scottjgibson/bobc_hardware/RosettaBone_Redux/RBR.Kit-Checklist.odt

100n

10u

100u

220R

330R

2K0

2K7

4k7

10k

100k

Shunt

SW_PUSH

Fuses

Terminal Blocks

Pololu Sockets

Dual row headers

Single row headers

KK Connectors

4-40 hardware

SS14

Yellow LED

Green LED

Red LED

2N7002K

DNM2075U

IRLB8743PBF

74CBTD3861

74ACT244

24C256

100n

10u

100u

220R

330R

2K0

2K7

4k7

10k

100k

Shunt

SW_PUSH

Fuses

Terminal Blocks

Pololu Sockets

Dual row headers

Single row headers

KK Connectors

4-40 hardware

SS14

Yellow LED

Green LED

Red LED

2N7002K

DNM2075U

IRLB8743PBF

74CBTD3861

74ACT244

24C256

100n

10u

100u

220R

330R

2K0

2K7

4k7

10k

100k

Shunt

SW_PUSH

Fuses

Terminal Blocks

Pololu Sockets

Dual row headers

Single row headers

KK Connectors

4-40 hardware

SS14

Yellow LED

Green LED

Red LED

2N7002K

DNM2075U

IRLB8743PBF

74CBTD3861

74ACT244

24C256

100n

10u

100u

220R

330R

2K0

2K7

4k7

10k

100k

Shunt

SW_PUSH

Fuses

Terminal Blocks

Pololu Sockets

Dual row headers

Single row headers

KK Connectors

4-40 hardware

SS14

Yellow LED

Green LED

Red LED

2N7002K

DNM2075U

IRLB8743PBF

74CBTD3861

74ACT244

24C256

100n

10u

100u

220R

330R

2K0

2K7

4k7

10k

100k

Shunt

SW_PUSH

Fuses

Terminal Blocks

Pololu Sockets

Dual row headers

Single row headers

KK Connectors

4-40 hardware

SS14

Yellow LED

Green LED

Red LED

2N7002K

DNM2075U

IRLB8743PBF

74CBTD3861

74ACT244

24C256

100n

10u

100u

220R

330R

2K0

2K7

4k7

10k

100k

Shunt

SW_PUSH

Fuses

Terminal Blocks

Pololu Sockets

Dual row headers

Single row headers

KK Connectors

4-40 hardware

SS14

Yellow LED

Green LED

Red LED

2N7002K

DNM2075U

IRLB8743PBF

74CBTD3861

74ACT244

24C256

100n

10u

100u

220R

330R

2K0

2K7

4k7

10k

100k

Shunt

SW_PUSH

Fuses

Terminal Blocks

Pololu Sockets

Dual row headers

Single row headers

KK Connectors

4-40 hardware

SS14

Yellow LED

Green LED

Red LED

2N7002K

DNM2075U

IRLB8743PBF

74CBTD3861

74ACT244

24C256

100n

10u

100u

220R

330R

2K0

2K7

4k7

10k

100k

Shunt

SW_PUSH

Fuses

Terminal Blocks

Pololu Sockets

Dual row headers

Single row headers

KK Connectors

4-40 hardware

SS14

Yellow LED

Green LED

Red LED

2N7002K

DNM2075U

IRLB8743PBF

74CBTD3861

74ACT244

24C256
