scottjgibson/bobc_hardware/RosettaBone_Redux/RBR-BOM-v1.1.xlsx

Sheet: CRAMPS-BOM
Item | Component | Notes | Quantity | Reference | Manufacturer | Part No. | Digikey Description | Digikey Part No | 1 | 10 | 25 | 50 | 100 | Cost
1 | 100u 35V |  | 7 | C201 C202 C203 C204 C205 C206 C402 | Nichicon | UCD1V101MCL6GS | CAP ALUM 100UF 35V 20% SMD | 493-6420-1-ND | 0.78000 | 0.65700 | 0.65700 | 0.65700 | 0.41170 | $5.46
2 | 10u 10V |  | 4 | C506 C507 C508 C509 | Taiyo Yuden | LMK212F106ZG-T | CAP CER 10UF 10V Y5V 0805 | 587-1312-1-ND | 0.20000 | 0.13800 | 0.13800 | 0.07940 | 0.65400 | $0.80
3 | 100n |  | 9 | C301 C302 C303 C401 C501 C502 C503 C504 C505 | Taiyo Yuden | GMK212BJ104KGHT | CAP CER 0.1UF 35V 10% X5R 0805 | 587-3364-1-ND | 0.30000 | 0.20100 | 0.20100 | 0.10440 | 0.08050 | $2.70
4 | ES1F |  | 6 | D401 D402 D403 D404 D405 D406 | Fairchild | ES1F | DIODE FAST REC 300V 1A SMA | ES1FCT-ND | 0.59000 | 0.42500 | 0.42500 | 0.33080 | 0.25060 | $3.54
5 | LED GRN |  | 3 | LD101 LD102 LD301 | Osram | LG R971-KN-1 | LED CHIPLED 570NM GREEN 0805 SMD | 475-1410-1-ND | 0.10000 | 0.08100 | 0.08100 | 0.08100 | 0.06540 | $0.30
6 | LED RED |  | 7 | LD302 LD401 LD402 LD403 LD404 LD405 LD406 | Osram | LH R974-LP-1 | LED CHIPLED 645NM RED DIFF 0805 | 475-1415-1-ND | 0.10000 | 0.08400 | 0.08400 | 0.08400 | 0.06600 | $0.70
7 | FUSE HOLDER |  | 3 | F201 F401 F402 | Keystone | 3588TR | FUSE HOLDER BLADE 500V 20A PCB | 3588KCT-ND | 1.62000 | 1.42500 | 1.42500 | 1.28560 | 1.22960 | $4.86
8 | FUSE 10A |  | 2 | F201 F401 | Littelfuse | 0297010.L | FUSE BLADE 10A 32V MINI FAST-AC | F4264-ND | 0.48000 | 0.45300 | 0.41720 | 0.38100 | 0.31640 | $0.96
9 | FUSE 15A |  | 1 | F402 | Littelfuse | 0297015.L | FUSE BLADE 15A 32V MINI FAST-AC | F4265-ND | 0.48000 | 0.45300 | 0.41720 | 0.38100 | 0.31640 | $0.48
10 | Power 3.5mm |  | 4 | P101 P406 P408 P411 | Phoenix | 1984617 | CONN TERM BLOCK T/H 2POS 3.5MM | 277-1721-ND | 0.48000 | 0.45500 | 0.45500 | 0.43500 | 0.42310 | $1.92
11 | Power 5.08mm |  | 4 | P204 P401 P402 P404 | Phoenix | 1715721 | CONN TERM BLOCK 2POS 5.08MM PCB | 277-1263-ND | 1.38000 | 1.32300 | 1.32300 | 1.26540 | 1.23090 | $5.52
12 | BB_EXP_CONN | 1 | 2 | P103 P104 | Major League | SSHQ-123-D-08-GT-LF | CONN RCPT .100" 46POS DUAL TIN |  | 2.50000 |  |  |  |  | $5.00
13 | Serial0 |  | 1 | P102 | Arduino |  | 6 pin stacking header |  | 0.25000 |  |  |  |  | $0.25
14 | Molex 2 pin |  | 3 | P302 P409 P410 | Molex | 22-23-2021 | CONN HEADER 2POS .100 VERT TIN | WM4200-ND | 0.24000 | 0.22200 | 0.18920 | 0.16580 | 0.15390 | $0.72
16 | Molex 4 pin |  | 7 | P205 P206 P207 P211 P212 P213 P407 | Molex | 22-23-2041 | CONN HEADER 4POS .100 VERT TIN | WM4202-ND | 0.44000 | 0.42400 | 0.36400 | 0.30920 | 0.29710 | $3.08
17 | Header 2 | 2 | 4 | P103 P104 P307 JP501 | Harwin | M20-9990245 | SIL VERTICAL PC TAIL PIN HEADER | 952-2261-ND | 0.17000 | 0.15200 | 0.11320 | 0.09700 | 0.09380 | $0.68
18 | Header 4 | 2 | 2 | P303 P304 | Harwin | M20-9990445 | DIL VERTICAL PC TAIL PIN HEADER | 952-2265-ND | 0.19000 | 0.18000 | 0.15320 | 0.13420 | 0.12460 | $0.38
19 | Header 6 | 2 | 2 | P305 P502 | Harwin | M20-9990645 | SIL VERTICAL PC TAIL PIN HEADER | 952-2269-ND | 0.29000 | 0.27000 | 0.23000 | 0.20140 | 0.18690 | $0.58
20 | Shunt | 4 | 3 | P301 JP501 | TE | 382811-8 | SHUNT, ECON, PHBR 5AU, BLACK | A26228-ND | 0.18700 | 0.18700 | 0.18700 | 0.11960 | 0.11550 | $0.56
21 | Header 2x2 | 2,3 | 0 | P301 | Harwin | M20-9980245 | DIL VERTICAL PC TAIL PIN HEADER | 952-2119-ND | 0.26000 | 0.24700 | 0.21080 | 0.18460 | 0.17140 | $0.00
22 | Header 3X2 | 2,3 | 0 | P201 P202 P203 P208 P209 P210 | Harwin | M20-9980345 | DIL VERTICAL PC TAIL PIN HEADER | 952-2120-ND | 0.29000 | 0.27000 | 0.23000 | 0.20140 | 0.18690 | $0.00
23 | Header 6X2 | 2 | 1 | P501 | Harwin | M20-9980645 | DIL VERTICAL PC TAIL PIN HEADER | 952-2125-ND | 0.53000 | 0.50300 | 0.43120 | 0.36660 | 0.35230 | $0.53
24 | Header 4X2 | 2 | 1 | P503 | Harwin | M20-9980445 | DIL VERTICAL PC TAIL PIN HEADER | 952-2122-ND | 0.36000 | 0.33600 | 0.28760 | 0.24440 | 0.23490 | $0.36
25 | 220R |  | 6 | R401 R403 R405 R408 R410 R411 | Stackpole | RMCF0805FT220R | RES 220 OHM 1/8W 1% 0805 | RMCF0805FT220RCT-ND | 0.05000 | 0.03700 | 0.03700 | 0.02060 | 0.01560 | $0.30
26 | 330R |  | 4 | R101 R102 R302 R305 | Stackpole | RMCF0805FT330R | RES 330 OHM 1/8W 1% 0805 | RMCF0805FT330RCT-ND | 0.05000 | 0.03700 | 0.03700 | 0.02060 | 0.01560 | $0.20
27 | 2K0 1% |  | 4 | R501 R502 R503 R504 | Stackpole | RMCF0805FT2K00 | RES 2K OHM 1/8W 1% 0805 | RMCF0805FT2K00CT-ND | 0.05000 | 0.03700 | 0.03700 | 0.02060 | 0.01560 | $0.20
28 | 2K7 |  | 6 | R402 R404 R406 R407 R409 R412 | Stackpole | RMCF0805FT2K70 | RES 2.7K OHM 1/8W 1% 0805 | RMCF0805FT2K70CT-ND | 0.05000 | 0.03700 | 0.03700 | 0.02060 | 0.01560 | $0.30
29 | 4k7 |  | 5 | R303 R505 R506 R507 R508 | Stackpole | RMCF0805FT4K70 | RES 4.7K OHM 1/8W 1% 0805 | RMCF0805FT4K70CT-ND | 0.05000 | 0.03700 | 0.03700 | 0.02060 | 0.01560 | $0.25
30 | 10k |  | 2 | R301 R304 | Stackpole | RMCF0805FT10K0 | RES 10K OHM 1/8W 1% 0805 | RMCF0805FT10K0CT-ND | 0.05000 | 0.03700 | 0.03700 | 0.02060 | 0.01560 | $0.10
31 | 100k |  | 6 | R201 R202 R203 R204 R205 R206 | Stackpole | RMCF0805FT100K | RES 100K OHM 1/8W 1% 0805 | RMCF0805FT100KCT-ND | 0.05000 | 0.03700 | 0.03700 | 0.02060 | 0.01560 | $0.30
32 | 10k Resitor Pack |  | 7 | RP301 RP302 RP303 RP304 RP305 RP501 RP502 | Bourns | CAT16-103J4LF | RES ARRAY 10K OHM 4 RES 1206 | CAT16-103J4LFCT-ND | 0.13000 | 0.08700 | 0.08280 | 0.07840 | 0.06800 | $0.91
33 | Switch |  | 2 | SW101 SW102 | TE | FSM2JH | SWITCH TACTILE SPST-NO 0.05A 12V | 450-1649-ND | 0.15000 | 0.14500 | 0.14080 | 0.13580 | 0.12820 | $0.30
34 | SM_DRIVER Socket |  | 4 | U201 U202 U203 U204 U205 U206 | Sullins | PPTC241LFBN-RC | CONN HEADER FEMALE 24POS.1" TIN | S7022-ND | 1.96000 | 1.61500 | 1.51400 | 1.34560 | 1.21110 | $7.84
35 | SM_DRIVER |  | 0 | U201 U202 U203 U204 U205 U206 | Pololu | 2133 | DRV8825 Stepper Motor Carrier, High Current |  | 13.95000 | 11.95000 | 10.25000 | 10.25000 | 8.75000 | $0.00
36 | 24C512 |  | 1 | U301 | On Semiconductor | CAT24C512WI-GT3 | IC EEPROM 512KBIT 1MHZ 8SOIC | CAT24C512WI-GT3OSCT-ND | 1.29000 | 1.14300 | 1.03200 | 1.03200 | 0.90290 | $1.29
37 | 74ACT244 |  | 1 | U302 | Fairchild | 74ACT244SCX | IC BUFF/DVR TRI-ST DUAL 20SOIC | 74ACT244SCXCT-ND | 0.78000 | 0.68200 | 0.60200 | 0.60200 | 0.52470 | $0.78
38 | 74CBTLV3861 |  | 1 | U501 | TI | SN74CBTD3861DW | IC 10-BIT FET BUS SW 24-SOIC | 296-6486-5-ND | 0.92000 | 0.92000 | 0.71320 | 0.71320 | 0.62120 | $0.92
39 | 2N7002 |  | 7 | Q101 Q301 Q302 Q303 Q304 Q305 Q306 | NXP | 2N7002P,215 | MOSFET N-CH SGL 60V SOT-23 | 568-5818-1-ND | 0.17000 | 0.15200 | 0.13920 | 0.13920 | 0.09990 | $1.19
40 | DMN2075U |  | 2 | Q403 Q405 | Diodes Inc | DMN2075U-7 | MOSFET N-CH 20V 4.2A SOT23 | DMN2075U-7DICT-ND | 0.54000 | 0.38800 | 0.30240 | 0.30240 | 0.22900 | $1.08
41 | IRLB8743PBF |  | 4 | Q401 Q402 Q404 Q406 | International Rectifier | IRLB8743PBF | MOSFET N-CH 30V 78A TO220AB | IRLB8743PBF-ND | 1.69000 | 1.04100 | 0.93120 | 0.84620 | 0.76140 | $6.76
 |  |  |  |  |  |  |  |  |  |  |  |  |  | $62.10
Notes
1 | Alternate stacking BeagleBone Headers:
 | MajorLeague SSHQ-123-D-08-GT-LF
 | Samtec SSQ-123-03-T-D (Tin)
 | Samtec SSQ-123-03-G-D (Gold)
 | Or use plain pin headers if you do not require additional expansion capes
2 | To save money on all the pin headers when buying parts for a few boards, you can get large breakaway headers
 | instead of the individual parts. You will need a total of:
 | 57 pins of single-row header
 | 74 pins of dual-row header
 | Which you can get using
 | (2) Harwin M20-9993645 36-pin single-row header
 | (2) Harwin M20-9983645 72-pin dual-row header
3 | These jumpers are optional. To use the on board shorts must be removed.
4 | Quantity required will vary. See note 3.

Sheet: Sheet1
4 | ES1F | 6 | D401 D402 D403 D404 D405 D406 | Fairchild | ES1F | DIODE FAST REC 300V 1A SMA | ES1FCT-ND | 0.59000 | 0.42500 | 0.42500 | 0.33080 | 0.25060 | $3.54
4 | SK310A-TP | 6 | D401 D402 D403 D404 D405 D406 | Micro Commercial | SK310A-TP | DIODE SCHOTTKY 100V 3A SMA | SK310A-TPCT-ND | 0.68000 | 0.47900 | 0.39400 | 0.31480 | 0.31480 | $4.08
4 | SK310A-TP | 6 | D401 D402 D403 D404 D405 D406 | Micro Commercial | SK4200L-TP | DIODE SCHOTTKY 200V 4A DO214AB | SK4200L-TPMSCT-ND | 0.59000 | 0.49400 | 0.43280 | 0.43280 | 0.37030 | $3.54
7 | FUSE HOLDER | 3 | F201 F401 F402 | Keystone | 3588TR | FUSE HOLDER BLADE 500V 20A PCB | 3588KCT-ND | 1.62000 | 1.42500 | 1.42500 | 1.28560 | 1.22960 | $4.86
7 | FUSE HOLDER | 6 | F201 F401 F402 | Keystone | 3557 | FUSE CLIP BLADE 500V 20A PCB | 3557K-ND | 0.26000 | 0.24000 | 0.24000 | 0.18760 | 0.16600 | $1.56
36 | 74ACT244 | 1 | U302 | Fairchild | 74ACT244SCX | IC BUFF/DVR TRI-ST DUAL 20SOIC | 74ACT244SCXCT-ND | 0.78000 | 0.68200 | 0.60200 | 0.60200 | 0.52470 | $0.78
36 | 74ACT244 | 1 | U302 | Fairchild | 74ACT244MTCX | IC BUFF/DVR TRI-ST DUAL 20TSSOP | 74ACT244MTCXCT-ND | 0.64000 | 0.53700 | 0.47040 | 0.47040 | 0.40250 | $0.64
37 | 74CBTLV3861 | 1 | U501 | TI | SN74CBTD3861DBQR | IC 10-BIT FET BUS SW 24QSOP | 296-6483-1-ND | 0.87000 | 0.76100 | 0.67280 | 0.67280 | 0.58630 | $0.87
37 | 74CBTLV3861 | 1 | U501 | TI | SN74CBTD3861DW | IC 10-BIT FET BUS SW 24-SOIC | 296-6486-5-ND | 0.92000 | 0.92000 | 0.71320 | 0.71320 | 0.62120 | $0.92
12 | BB_EXP_CONN | 2 | P103 P104 | SamTec | SSQ-123-03-T-D | CONN RCPT .100" 46POS DUAL TIN | SAM1204-23-ND | 5.93000 | 5.30600 | 5.30600 | 5.30600 | 4.37010 | $11.86
12 | BB_EXP_CONN | 2 | P103 P104 | Major League | SSHQ-123-D-08-GT-LF | CONN RCPT .100" 46POS DUAL TIN |  | 2.50000 |  |  |  |  | $5.00
14 | Molex 2 pin | 3 | P302 P409 P410 | Molex | 22-23-2021 | CONN HEADER 2POS .100 VERT TIN | WM4200-ND | 0.24000 | 0.22200 | 0.18920 | 0.16580 | 0.15390 | $0.72
14 | Molex 2 pin | 3 | P302 P409 P410 | Molex | 20-60-4020 | CONN HEADER 2POS .156 VERT TIN | WM4620-ND | 0.31000 | 0.29300 | 0.25160 | 0.21380 | 0.20540 | $0.93
10 | Power 3.5mm | 4 | P101 P406 P408 P411 | Phoenix | 1984617 | CONN TERM BLOCK T/H 2POS 3.5MM | 277-1721-ND | 0.48000 | 0.45500 | 0.45500 | 0.43500 | 0.42310 | $1.92
10 | Molex 2 pin | 4 | P302 P409 P410 | Molex | 20-60-4020 | CONN HEADER 2POS .156 VERT TIN | WM4620-ND | 0.31000 | 0.29300 | 0.25160 | 0.21380 | 0.20540 | $1.24
