scottjgibson/bobc_hardware/RosettaBone_Redux/RBR.BOM.DK.V1.0.xls

Digi-Key Part Number | Manufacturer | Manufacturer Part Number | Customer Reference | Quantity 1 | Quantity 2 | Quantity 3 | Mfg Std Lead Time | Description | Comments | RoHS Status | Lead Free Status | REACH Status
CAT16-103J4LFCT-ND | BOURNS INC (VA) | CAT16-103J4LF | RP1..RP802 | 5 | 0 | 0 | 12 Weeks | RES ARRAY 10K OHM 4 RES 1206 | Alternate Packaging Exists | RoHS Compliant | Lead free | Not Available
2N7002K-7DICT-ND | DIODES INCORPORATED (VA) | 2N7002K-7 | Q1..Q101,Q401,Q402 | 5 | 0 | 0 | 7 Weeks | MOSFET N-CH 60V 300MA SOT23-3 | Alternate Packaging Exists | RoHS Compliant | Lead free | Unaffected Jun-2012
DMN2075U-7DICT-ND | DIODES INCORPORATED (VA) | DMN2075U-7 | Q901,Q902 | 2 | 0 | 0 | 8 Weeks | MOSFET N-CH 20V 4.2A SOT23 | Alternate Packaging Exists | RoHS Compliant | Lead free | Unaffected Jun-2012
74ACT244SC-ND | FAIRCHILD SEMICONDUCTOR | 74ACT244SC | U2 | 1 | 0 | 0 | 7 Weeks | IC BUFF/DVR TRI-ST DUAL 20SOIC |  | RoHS Compliant | Lead free | Unaffected Jun-2011
LM7812ACT-ND | FAIRCHILD SEMICONDUCTOR | LM7812ACT | U3 | 1 | 0 | 0 | 7 Weeks | IC REG LDO 12V 1A TO220-3 |  | RoHS Compliant | Lead free | Unaffected Jun-2011
ES1FCT-ND | FAIRCHILD SEMICONDUCTOR (VA) | ES1F | D401..D404,D903,D904 | 6 | 0 | 0 | 7 Weeks | DIODE FAST REC 300V 1A SMA | Alternate Packaging Exists | RoHS Compliant | Lead free | Unaffected Jun-2011
952-1809-ND | HARWIN INC | M20-7820646 | P103 | 1 | 0 | 0 | 8 Weeks | 06-WAY SIL VERT SOCKET L/FREE |  | RoHS Compliant | Lead free | Not Available
952-2131-ND | HARWIN INC | M20-9983645 | DUAL ROW | 2 | 0 | 0 | 8 Weeks | DIL VERTICAL PC TAIL PIN HEADER |  | RoHS Compliant | Lead free | Not Available
952-2272-ND | HARWIN INC | M20-9993645 | SINGLE ROW | 2 | 0 | 0 | 8 Weeks | SIL VERTICAL PC TAIL PIN HEADER |  | RoHS Compliant | Lead free | Not Available
IRLB8743PBF-ND | INTERNATIONAL RECTIFIER | IRLB8743PBF | Q201..Q206 | 4 | 0 | 0 | 11 Weeks | MOSFET N-CH 30V 78A TO220AB |  | RoHS Compliant | Lead free | Unaffected Jun-2012
F065-ND | LITTELFUSE INC | 01530008Z | F101,F102,F103 | 3 | 0 | 0 | 9-11 Weeks | FUSE HOLDER BLADE 32V 15A PCB |  | RoHS Compliant | Lead free | Not Available
1N4148WXTPMSCT-ND | MICRO COMMERCIAL CO (VA) | 1N4148WX-TP | D1001..D1008 | 8 | 0 | 0 | 8 Weeks | DIODE SWITCHING 75V 0.15A SOD323 | Alternate Packaging Exists | RoHS Compliant | Lead free | Unaffected Jun-2012
WM4200-ND | MOLEX INC | 0022232021 | P105,P302,P901,P902 | 4 | 0 | 0 | 5 Weeks | CONN HEADER 2POS .100 VERT TIN |  | RoHS Compliant | Lead free | Unaffected Dec-2009
WM4204-ND | MOLEX INC | 0022232061 | P204,P205,P206,P210,P212,P217 | 6 | 0 | 0 | 5 Weeks | CONN HEADER 6POS .100 VERT TIN |  | RoHS Compliant | Lead free | Unaffected Dec-2009
493-6420-1-ND | NICHICON (VA) | UCD1V101MCL6GS | C10,C201..C206 | 7 | 0 | 0 | 14 Weeks | CAP ALUM 100UF 35V 20% SMD | Alternate Packaging Exists | RoHS Compliant | Lead free | Unaffected Jun-2012
MC74ACT125DGOS-ND | ON SEMICONDUCTOR | MC74ACT125DG | U1 | 1 | 0 | 0 | 5 Weeks | IC BUFF TRI-ST QD N-INV 14SOIC | Alternate Packaging Exists | RoHS Compliant | Lead free | Unaffected Jun-2012
CAT24C512WI-GT3OSCT-ND | ON SEMICONDUCTOR (VA) | CAT24C512WI-GT3 | U601 | 1 | 0 | 0 | 5 Weeks | IC EEPROM 512KBIT 1MHZ 8SOIC | Alternate Packaging Exists | RoHS Compliant | Lead free | Unaffected Jun-2012
475-1410-1-ND | OSRAM OPTO SEMICONDUCTORS INC(VA) | LG R971-KN-1 | D101 | 1 | 0 | 0 | 6-8 Weeks | LED CHIPLED 570NM GREEN 0805 SMD | Alternate Packaging Exists | RoHS Compliant | Lead free | Unaffected Aug-2011
475-1415-1-ND | OSRAM OPTO SEMICONDUCTORS INC(VA) | LH R974-LP-1 | D201..D204,D901,D902 | 6 | 0 | 0 | 6-8 Weeks | LED CHIPLED 645NM RED DIFF 0805 | Alternate Packaging Exists | RoHS Compliant | Lead free | Unaffected Aug-2011
277-1263-ND | PHOENIX CONTACT | 1715721 | P101,P107,P108,P404 | 4 | 0 | 0 | 5 Weeks | CONN TERM BLOCK 2POS 5.08MM PCB |  | RoHS Compliant | Lead free | Unaffected Oct-2011
277-1721-ND | PHOENIX CONTACT | 1984617 | P218,P219,P403,P405 | 4 | 0 | 0 | 5 Weeks | CONN TERM BLOCK T/H 2POS 3.5MM |  | RoHS Compliant | Lead free | Unaffected Oct-2011
SAM1196-23-ND | SAMTEC INC (VA) | SSQ-123-03-G-D | U4 | 2 | 0 | 0 |  | CONN RCPT .100" 46POS DUAL GOLD | MUCH CHEAPER FROM MAJOR LEAGUE! | RoHS Compliant | Lead free | Unaffected Jun-2012
RMCF0805FT100KCT-ND | STACKPOLE ELECTRONICS INC (VA) | RMCF0805FT100K | R201..R210 | 6 | 0 | 0 | 9 Weeks | RES 100K OHM 1/8W 1% 0805 | Alternate Packaging Exists | RoHS Compliant | Lead free | Unaffected Aug-2011
RMCF0805FT12K4CT-ND | STACKPOLE ELECTRONICS INC (VA) | RMCF0805FT12K4 | R1004 | 1 | 0 | 0 | 9 Weeks | RES 12.4K OHM 1/8W 1% 0805 | Alternate Packaging Exists | RoHS Compliant | Lead free | Unaffected Aug-2011
RMCF0805FT1K00CT-ND | STACKPOLE ELECTRONICS INC (VA) | RMCF0805FT1K00 | R301..R303,R501,R1002 | 5 | 0 | 0 | 9 Weeks | RES 1K OHM 1/8W 1% 0805 | Alternate Packaging Exists | RoHS Compliant | Lead free | Unaffected Aug-2011
RMCF0805FT1K80CT-ND | STACKPOLE ELECTRONICS INC (VA) | RMCF0805FT1K80 | R905,R906 | 2 | 0 | 0 | 9 Weeks | RES 1.8K OHM 1/8W 1% 0805 | Alternate Packaging Exists | RoHS Compliant | Lead free | Unaffected Aug-2011
RMCF0805FT10K0RCT-ND | STACKPOLE ELECTRONICS INC (VA) | RMCF0805FT10K0R | R1,R2,R211,R212,R401,R402 | 6 | 0 | 0 | 9 Weeks | RES 10K OHM 1/8W 1% 0805 | Alternate Packaging Exists | RoHS Compliant | Lead free | Unaffected Aug-2011
RMCF0805FT220RCT-ND | STACKPOLE ELECTRONICS INC (VA) | RMCF0805FT220R | R701..R902 | 6 | 0 | 0 | 9 Weeks | RES 220 OHM 1/8W 1% 0805 | Alternate Packaging Exists | RoHS Compliant | Lead free | Unaffected Aug-2011
RMCF0805FT2K15CT-ND | STACKPOLE ELECTRONICS INC (VA) | RMCF0805FT2K15 | R1003 | 1 | 0 | 0 | 9 Weeks | RES 2.15K OHM 1/8W 1% 0805 | Alternate Packaging Exists | RoHS Compliant | Lead free | Unaffected Aug-2011
RMCF0805FT2K70CT-ND | STACKPOLE ELECTRONICS INC (VA) | RMCF0805FT2K70 | R219..R222 | 4 | 0 | 0 | 9 Weeks | RES 2.7K OHM 1/8W 1% 0805 | Alternate Packaging Exists | RoHS Compliant | Lead free | Unaffected Aug-2011
RMCF0805FT330RCT-ND | STACKPOLE ELECTRONICS INC (VA) | RMCF0805FT330R | R101 | 1 | 0 | 0 | 9 Weeks | RES 330 OHM 1/8W 1% 0805 | Alternate Packaging Exists | RoHS Compliant | Lead free | Unaffected Aug-2011
RMCF0805FT4K70CT-ND | STACKPOLE ELECTRONICS INC (VA) | RMCF0805FT4K70 | R304,R305,R502..R50 | 6 | 0 | 0 | 9 Weeks | RES 4.7K OHM 1/8W 1% 0805 | Alternate Packaging Exists | RoHS Compliant | Lead free | Unaffected Aug-2011
 | SULLINS CONNECTOR SOLUTIONS | PPTC241LFBN-RC | U201..U206 | 4 | 0 | 0 | 2-4 Weeks | CONN HEADER FEMALE 24POS.1" TIN |  | RoHS Compliant | Lead free | Unaffected Sep-2008
587-3364-1-ND | TAIYO YUDEN (VA) | GMK212BJ104KGHT | C1,C2,C102,C207,C305,C502..C601 | 10 | 0 | 0 | 6 Weeks | CAP CER 0.1UF 35V 10% X5R 0805 | Alternate Packaging Exists | RoHS Compliant | Lead free | Not Available
587-1312-1-ND | TAIYO YUDEN (VA) | LMK212F106ZG-T | C301..C303,C501,C1001 | 5 | 0 | 0 | 6 Weeks | CAP CER 10UF 10V Y5V 0805 | Alternate Packaging Exists | RoHS Compliant | Lead free | Unaffected Nov-2009
450-1649-ND | TE CONNECTIVITY ALCOSWITCH | FSM2JH | SW101,SW10 | 2 | 0 | 0 | 13 Weeks | SWITCH TACTILE SPST-NO 0.05A 12V |  | RoHS Compliant | Lead free | Unaffected Aug-2011
296-6483-1-ND | TEXAS INSTRUMENTS (VA) | SN74CBTD3861DBQR | U5 | 1 | 0 | 0 | 7 Weeks | IC 10-BIT FET BUS SW 24QSOP | Alternate Packaging Exists | RoHS Compliant | Lead free | Unaffected Jun-2012
296-18914-1-ND | TEXAS INSTRUMENTS (VA) | TLV431CDBZR | U1001 | 1 | 0 | 0 | 9 Weeks | IC VREF SHUNT PREC ADJ SOT23-3 | Alternate Packaging Exists | RoHS Compliant | Lead free | Unaffected Jun-2012
SS10P4-M3/86AGICT-ND | VISHAY SEMICONDUCTOR DIODES DIVISION (VA) | SS10P4-M3/86A | D102 | 1 | 0 | 0 | 4 Weeks | DIODE SCHOTTKY 40V 10A TO277A | Alternate Packaging Exists | RoHS Compliant | Lead free | Unaffected Dec-2011
