scottjgibson/bobc_hardware/RosettaBone_Redux/RBR.pdf

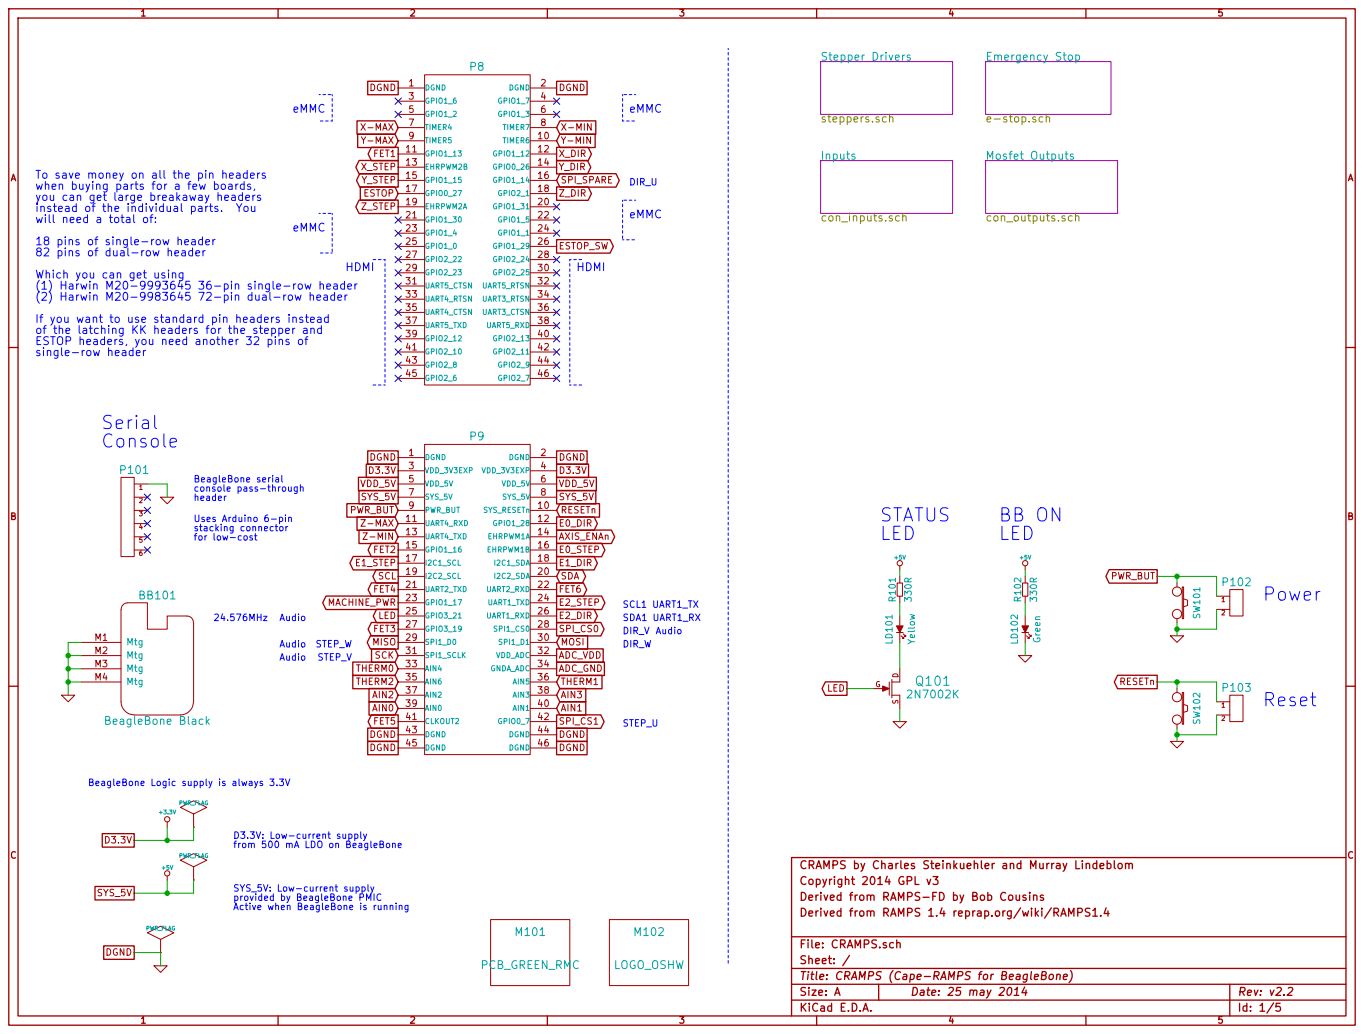
[picture p1: page 1]

To save money on all the pin headers
when buying parts for a few boards,
you can get large breakaway headers
instead of the individual parts. You will need a total of: 18 pins of single-row header

82 pins of dual-row header
Which you can get using
(1) Harwin M20-9993645 36-pin single-row header
(2) Harwin M20-9983645 72-pin dual-row header
If you want to use standard pin headers instead
of the latching KK headers for the stepper and
ESTOP headers, you need another 32 pins of

BeagleBone Logic supply is always 3.3V

D3.3V: Low-current supply
from 500 mA LDO on BeagleBone

CRAMPS by Charles Steinkuehler and Murray Lindeblom
Copyright 2014 GPL v3
Derived from RAMPS-FD by Bob Cousins
Derived from RAMPS 1.4 reprap.org/wiki/RAMPS1.4

provided by BeagleBone PMIC
Active when BeagleBone is running

File: CRAMPS.sch
Sheet: /
Title: CRAMPS (Cape-RAMPS for BeagleBone)
KiCad E.D.A.

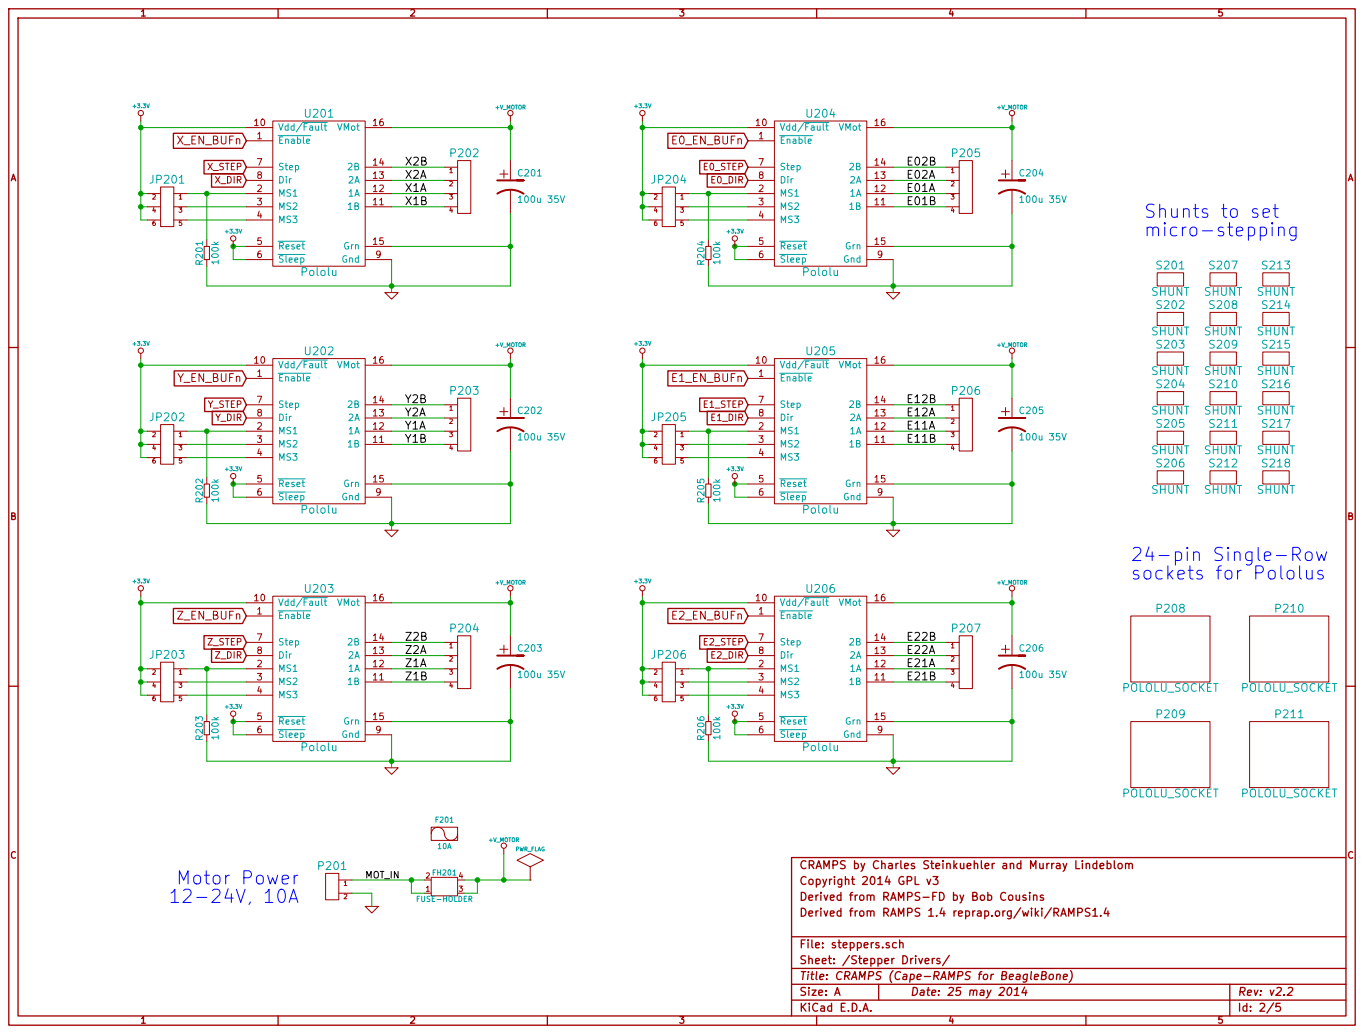
[picture p2: page 2]
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

File: steppers.sch
Sheet: /Stepper Drivers/
Title: CRAMPS (Cape-RAMPS for BeagleBone)

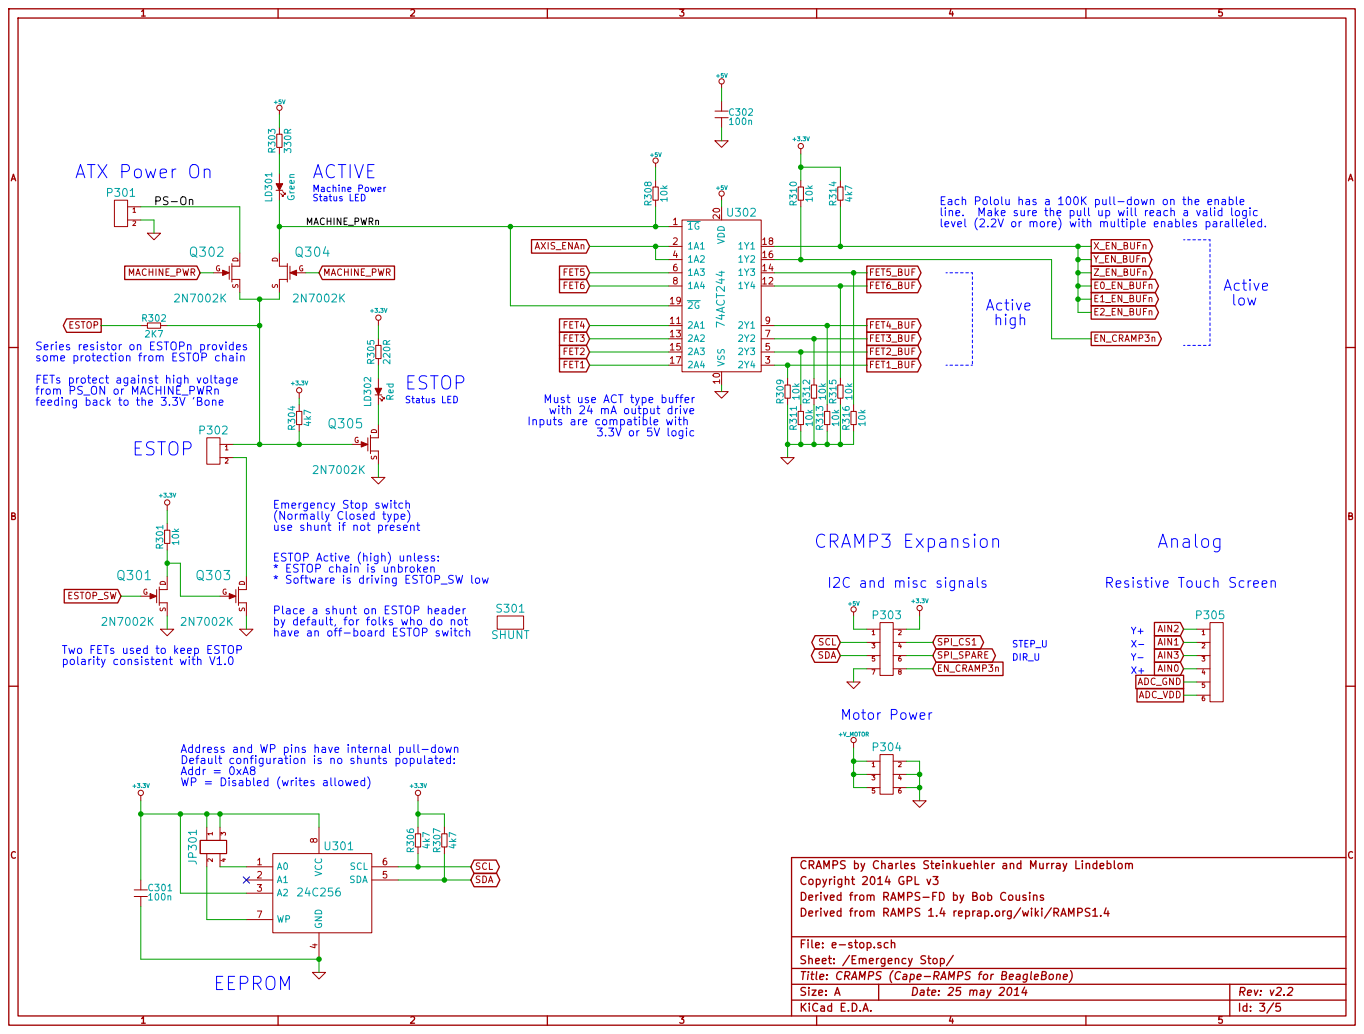
[picture p3: page 3]

Each Pololu has a 100K pull-down on the enable
line. Make sure the pull up will reach a valid logic

level (2.2V or more) with multiple enables paralleled. ESTOP

Series resistor on ESTOPn provides
some protection from ESTOP chain
FETs protect against high voltage
from PS_ON or MACHINE_PWRn
feeding back to the 3.3V 'Bone

Must use ACT type buffer
with 24 mA output drive
Inputs are compatible with

ESTOP Active (high) unless:
* ESTOP chain is unbroken
* Software is driving ESTOP_SW low

Place a shunt on ESTOP header
by default, for folks who do not
have an off-board ESTOP switch

Two FETs used to keep ESTOP
polarity consistent with V1.0

100n Address and WP pins have internal pull-down
Default configuration is no shunts populated: Addr = 0xA8 WP = Disabled (writes allowed)

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

File: e-stop.sch
Sheet: /Emergency Stop/
Title: CRAMPS (Cape-RAMPS for BeagleBone)

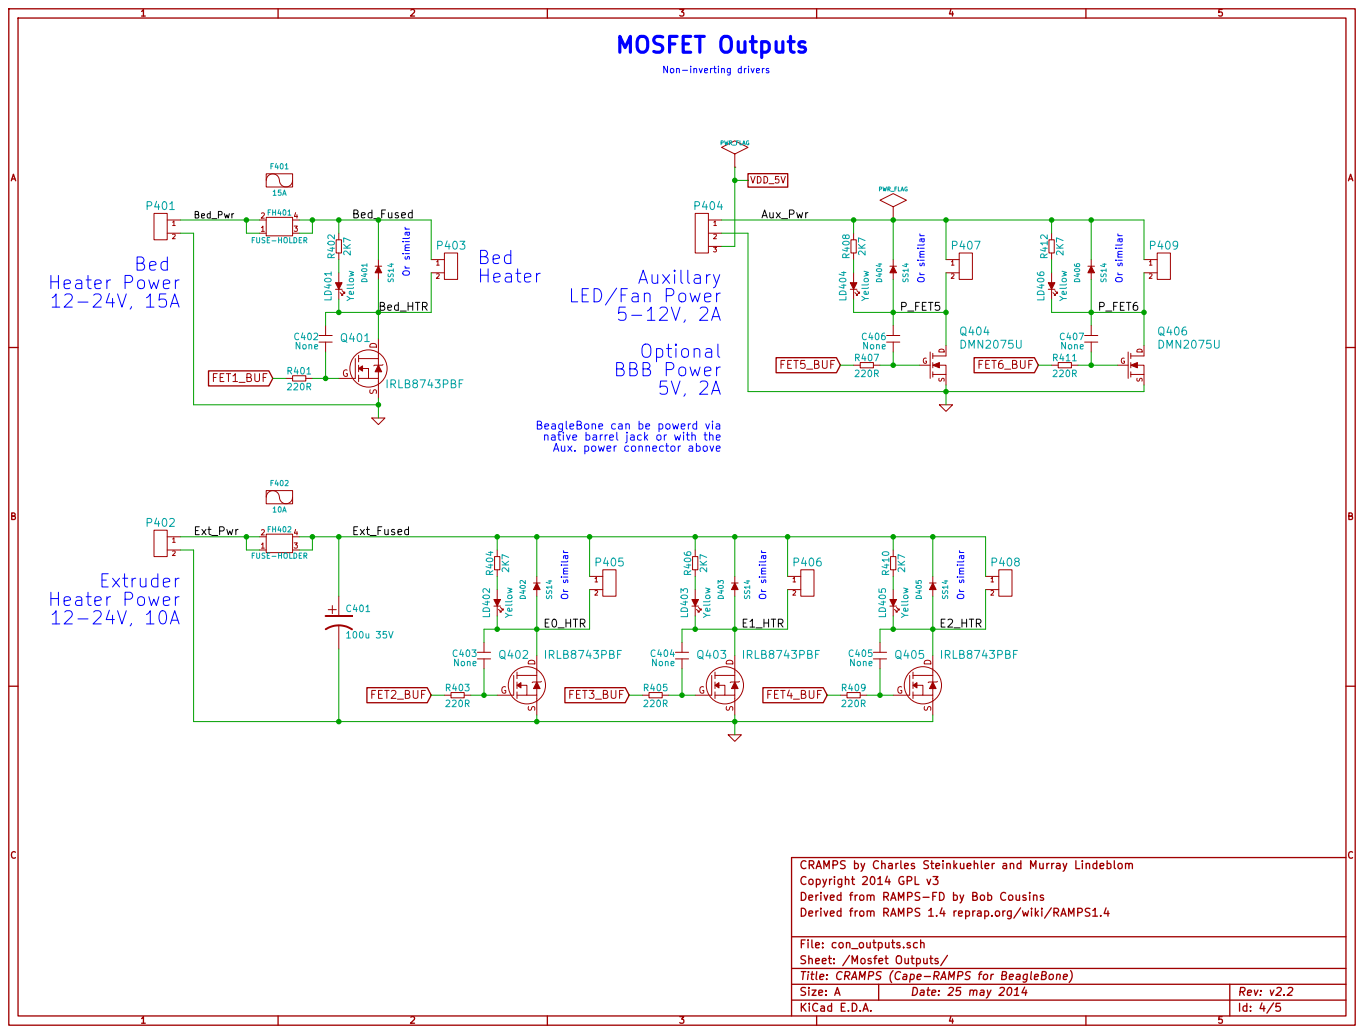
[picture p4: page 4]

BeagleBone can be powerd via
native barrel jack or with the
Aux. power connector above

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

File: con_outputs.sch
Sheet: /Mosfet Outputs/
Title: CRAMPS (Cape-RAMPS for BeagleBone)

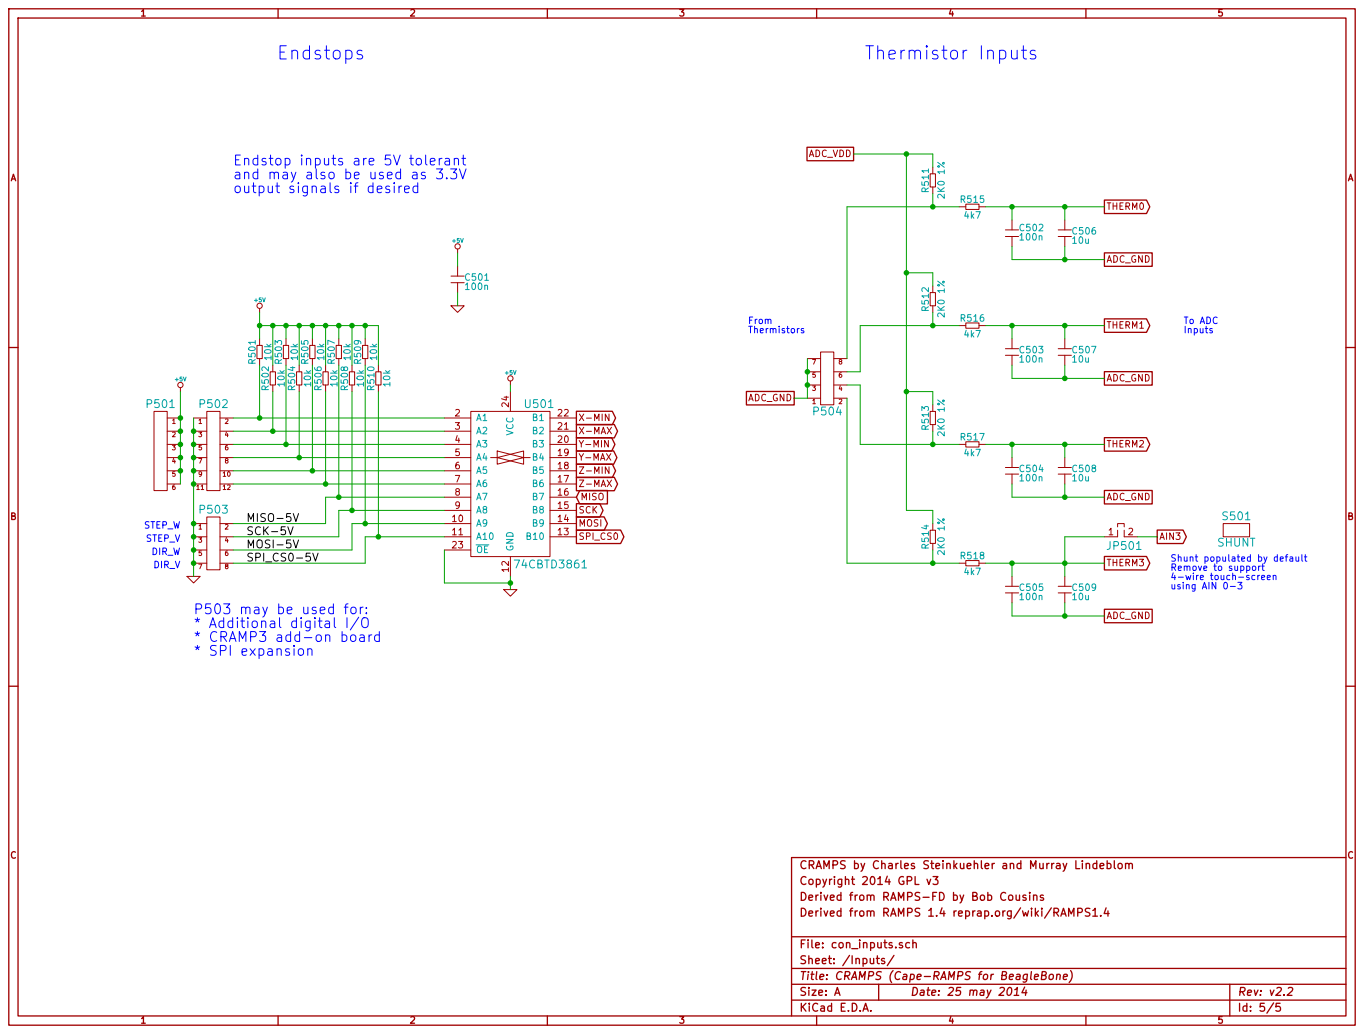
[picture p5: page 5]

100n Endstop inputs are 5V tolerant
and may also be used as 3.3V
output signals if desired

1 | 2 SCK-5V
3 | 4 MOSI-5V
5 | 6 SPI_CS0-5V

Remove to support 4-wire touch-screen

P503 may be used for:
* Additional digital I/O
* CRAMP3 add-on board
* SPI expansion

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

File: con_inputs.sch
Sheet: /Inputs/
Title: CRAMPS (Cape-RAMPS for BeagleBone)
