scottjgibson/bobc_hardware/RosettaBone_Redux/RBR.kicad_pcb

## KiCad design RosettaBone_Redux/RBR.kicad_pcb (2015-01-14)

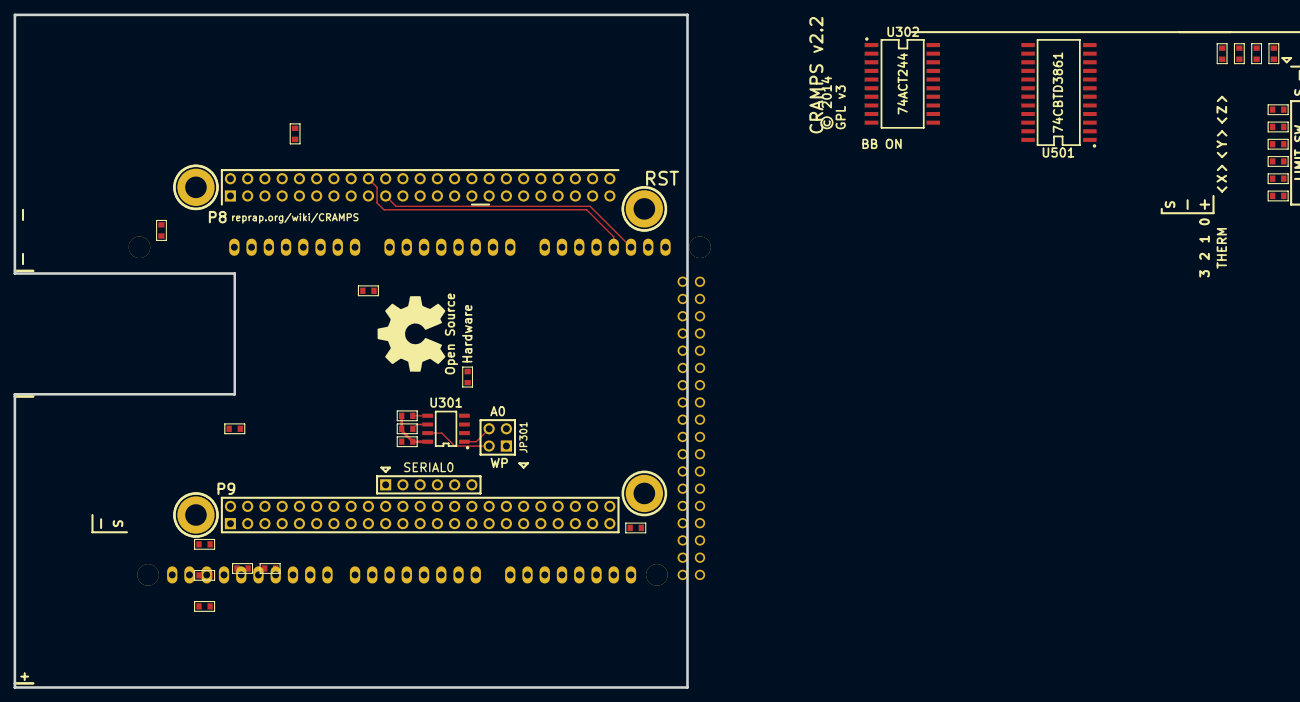
[picture p6: board RBR.kicad_pcb from above]

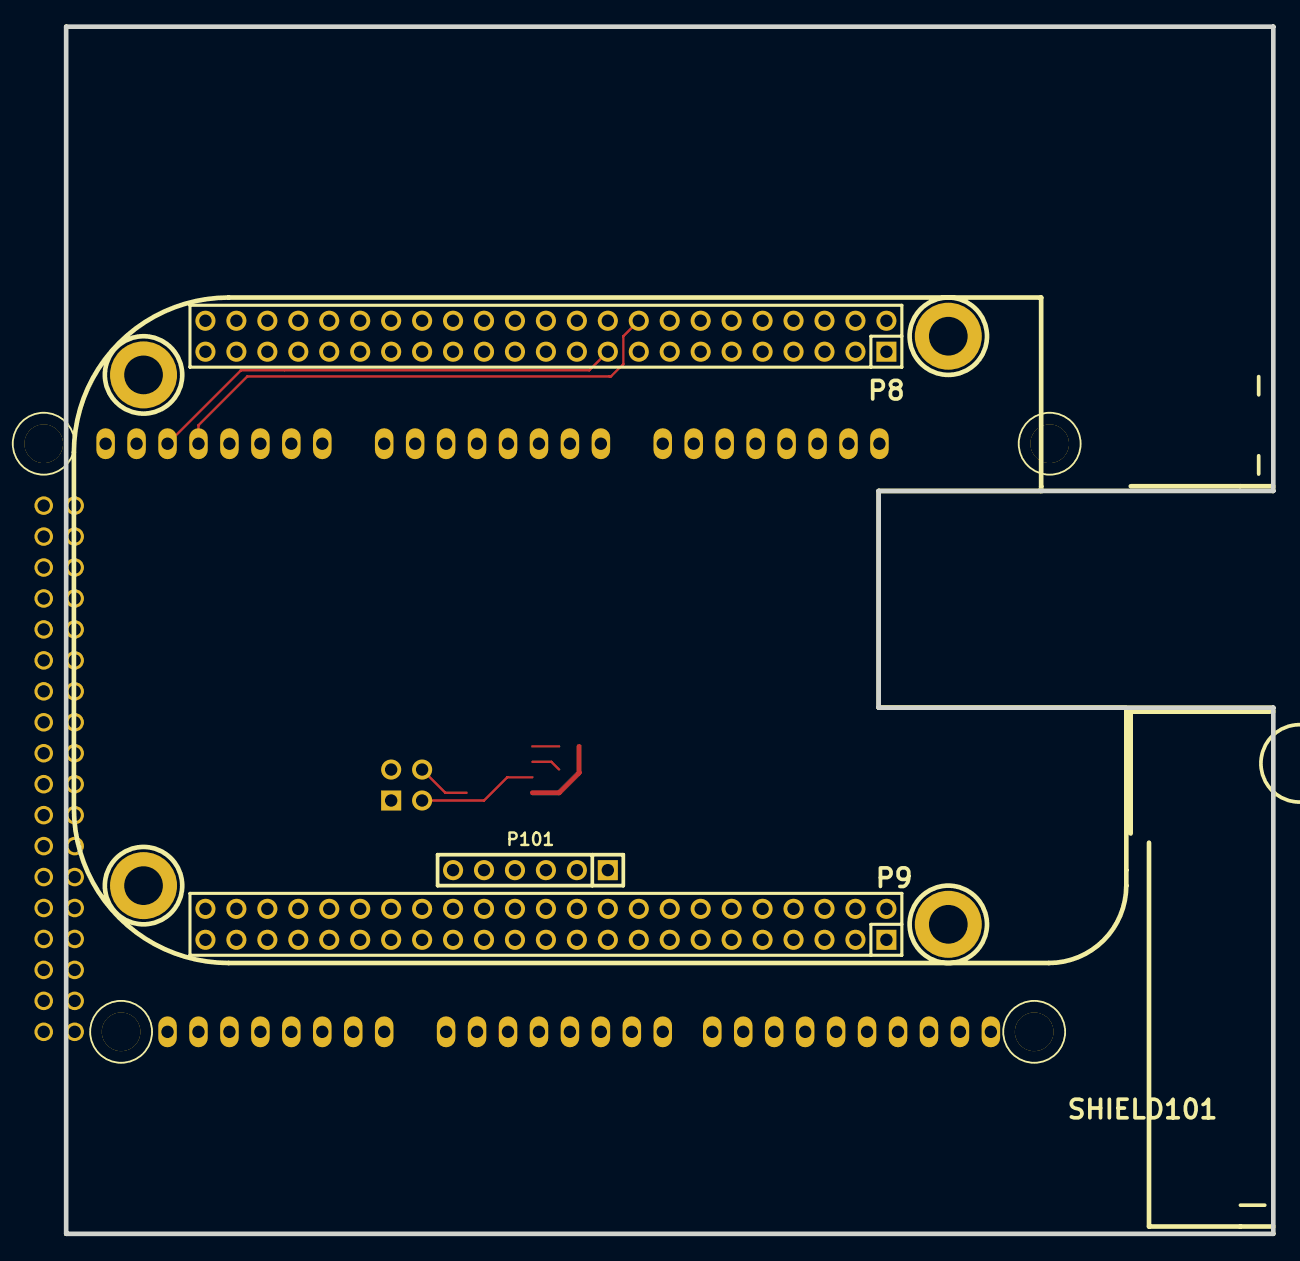
[picture p7: board RBR.kicad_pcb from below]

Board: 2 copper layers, 99.1 x 99.1 mm, 35 parts (5 on the bottom side), 61 nets.

Parts:
BB101: BeagleBone Black; BeagleBone-Pins
C301, C302, C501: 100n; CAPC1608x55N
JP301: HEADER_2X2; pin_strip_2x2
M101: PCB_GREEN_RMC; OSHW_logo_2
M102: LOGO_OSHW; PCB_GREEN_RMC
P8, P9: BB_EXP_CONN; P8P9_PinHeader
P101: SOCKET_6_LONG; pin_strip_6
R306, R307, R314: 4k7; RESC1608x55N
R308, R309, R310, R311, R312, R313, R315, R316, R501, R502, R503, R504, R505, R506, R507, R508, R509, R510: 10k; RESC1608x55N
SHIELD101: ARDUINO_DUE_SHIELD; ARDUINO_MEGA_DUE_SHIELD_FOOTPRINT_RMC
U301: 24C256; SOIC127P600X175-8AN
U302: 74ACT244; SOIC127P1032X265-20N
U501: 74CBTD3861; SOIC127P1030X265-24N

Connections:
/Inputs/MISO-5V: R507.2, U501.8
/Inputs/MOSI-5V: R509.2, U501.10
/Inputs/SCK-5V: R508.2, U501.9
/Inputs/SPI_CS0-5V: R510.2, U501.11
AXIS_ENAn: P9.14, U302.2, U302.4
D3.3V: C301.1, JP301.1, JP301.3, P9.3, P9.4, R306.1, R307.1, R310.1, R314.1, SHIELD101.3V3, U301.3, U301.8
D32: P9.24, SHIELD101.32
D41: P9.18, SHIELD101.41
D43: P9.17, SHIELD101.43
D47: P9.26, SHIELD101.47
DGND: BB101.M1, BB101.M2, BB101.M3, BB101.M4, C301.2, C302.2, C501.2, P8.1, P8.2, P9.1, P9.2, P9.43, P9.44, P9.45, P9.46, P101.1, R309.2, R311.2, R312.2, R313.2, R315.2, R316.2, SHIELD101.GND, U301.4, U302.10, U501.12, U501.23
E0_DIR: P9.12, SHIELD101.28
E0_EN_BUFn: R314.2, U302.18
E0_STEP: P9.16, SHIELD101.36
EN_CRAMP3n: R310.2, U302.16
ESTOP: P8.17, SHIELD101.40
FET1: P8.11, U302.17
FET1_BUF: R309.1, U302.3
FET2: P9.15, U302.15
FET2_BUF: R311.1, U302.5
FET3: P9.27, U302.13
FET3_BUF: R312.1, U302.7
FET4: P9.21, U302.11
FET4_BUF: R313.1, U302.9
FET5: P9.41, U302.6
FET5_BUF: R316.1, U302.14
FET6: P9.22, U302.8
FET6_BUF: R315.1, U302.12
GNDA: SHIELD101.GND4, SHIELD101.GND5
MISO: P9.29, U501.16
MOSI: P9.30, U501.14
unnamed: R506.2, U501.7
unnamed: R505.2, U501.6
unnamed: R504.2, U501.5
unnamed: R503.2, U501.4
unnamed: R502.2, U501.3
unnamed: R501.2, U501.2
unnamed: JP301.2, U301.7
unnamed: JP301.4, U301.1
SCK: P9.31, U501.15
SCL: P9.19, R306.2, SHIELD101.21, U301.6
SDA: P9.20, R307.2, SHIELD101.20, U301.5
SPI_CS0: P9.28, U501.13
SPI_CS1: P9.42, SHIELD101.4
SYS_5V: C302.1, C501.1, P9.7, P9.8, R308.1, R501.1, R502.1, R503.1, R504.1, R505.1, R506.1, R507.1, R508.1, R509.1, R510.1, U302.20, U501.24
THERM0: P9.33, SHIELD101.AD0
THERM1: P9.36, SHIELD101.AD1
THERM2: P9.35, SHIELD101.AD2
VDD_5V: P9.5, P9.6
X-MAX: P8.7, SHIELD101.30, U501.21
X-MIN: P8.8, SHIELD101.22, U501.22
X_DIR: P8.12, SHIELD101.AD8
X_STEP: P8.13, SHIELD101.AD9
Y-MAX: P8.9, SHIELD101.38, U501.19
Y-MIN: P8.10, SHIELD101.24, U501.20
Y_DIR: P8.14, SHIELD101.AD10
Y_STEP: P8.15, SHIELD101.AD11
Z-MAX: P9.11, SHIELD101.34, U501.17
Z-MIN: P9.13, SHIELD101.26, U501.18
Z_DIR: P8.18, SHIELD101.AD12
Z_STEP: P8.19, SHIELD101.AD13
