scottjgibson/bobc_hardware/RosettaBone_Redux/RBR.sch

## KiCad design RosettaBone_Redux/RBR.sch (2015-01-14, an earlier design)

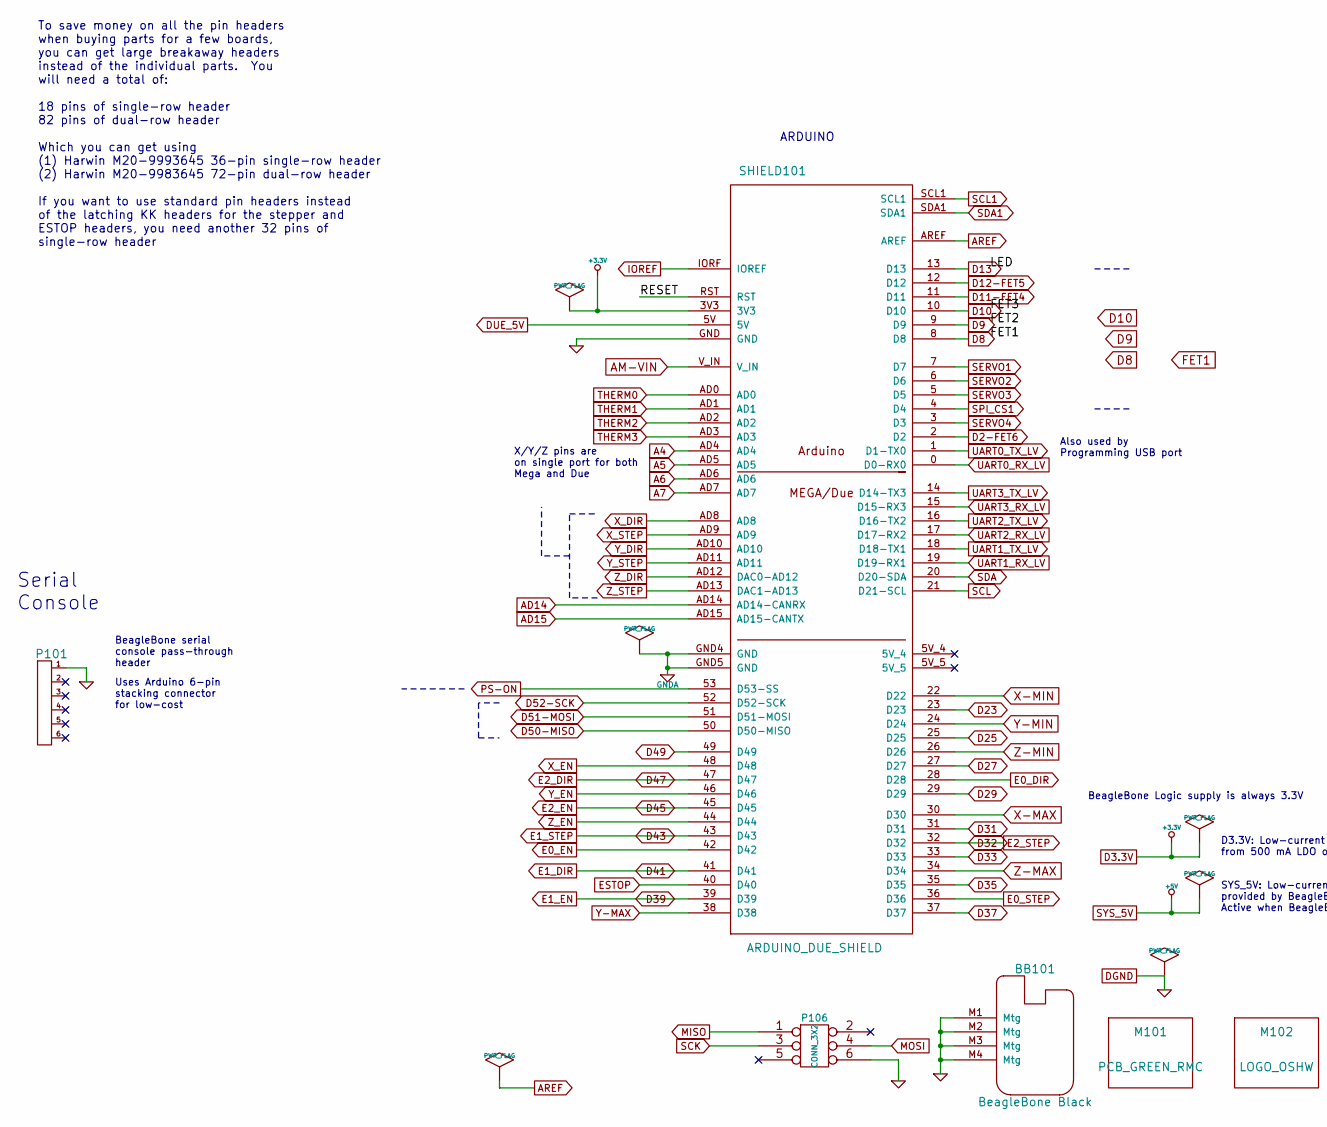
[picture p8: schematic RBR.sch, part in row 1, column 1]

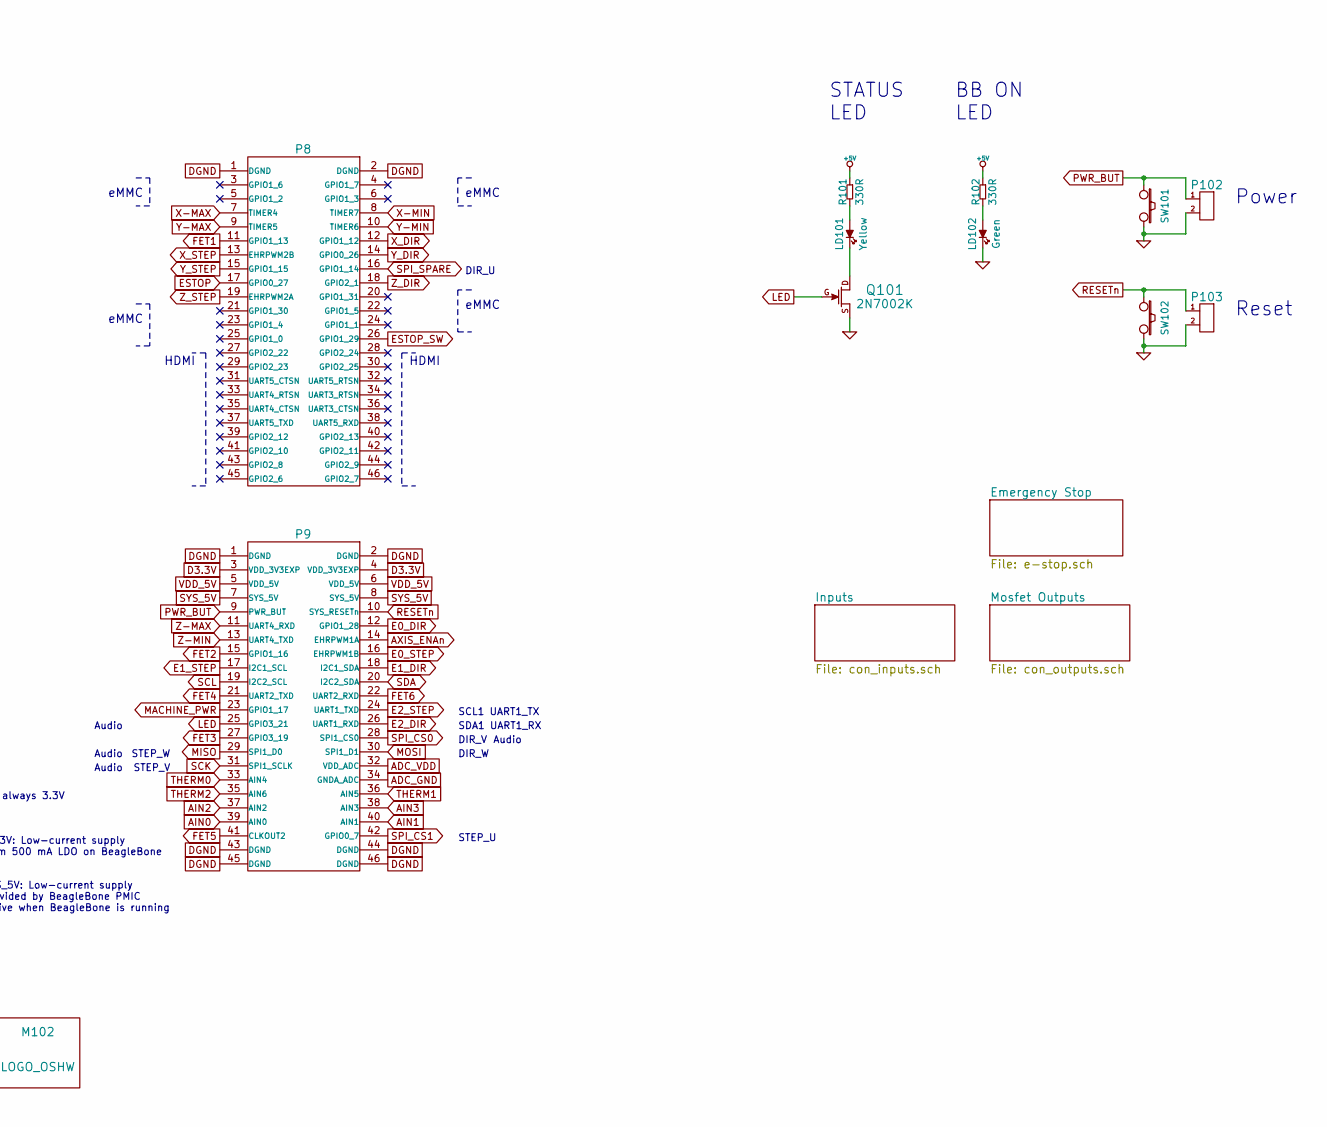
[picture p9: schematic RBR.sch, part in row 1, column 2]

Parts:
BB101: BeagleBone Black; BeagleBone-Pins; PartNo BB-BBLK-000
LD101: Yellow; OSRAM-LED-0603; PartNo LY Q976-P1S2-36
LD102: Green; OSRAM-LED-0603; PartNo LG Q971-KN-1
M101: PCB_GREEN_RMC; OSHW_logo_2; PartNo Part of PCB
M102: LOGO_OSHW; PCB_GREEN_RMC; PartNo Part of PCB
P8, P9: BB_EXP_CONN; P8P9_PinHeader; PartNo TSHC-123-D-06-240-GT-LF
P101: SOCKET_6_LONG; pin_strip_6; PartNo PRT-09280
P102, P103: HEADER_2; pin_strip_2; PartNo M20-9990245
P106: CONN_3X2
Q101: 2N7002K; SOT23GDS; PartNo 2N7002K-7
R101, R102: 330R; RESC1608x55N; PartNo RMCF0603FT330R
SHIELD101: ARDUINO_DUE_SHIELD
SW101, SW102: SW_PUSH; SW_6x6_MULTI; PartNo FSM2JH

Connections:
+3.3V: P9.3 (VDD_3V3EXP), P9.4 (VDD_3V3EXP), SHIELD101.3V3
+5V: P9.7 (SYS_5V), P9.8 (SYS_5V), R101.1, R102.1
A4: SHIELD101.AD4
A5: SHIELD101.AD5
A6: SHIELD101.AD6
A7: SHIELD101.AD7
AD14: SHIELD101.AD14 (AD14-CANRX)
AD15: SHIELD101.AD15 (AD15-CANTX)
ADC_GND: P9.34 (GNDA_ADC)
ADC_VDD: P9.32 (VDD_ADC)
AIN0: P9.39 (AIN0)
AIN1: P9.40 (AIN1)
AIN2: P9.37 (AIN2)
AIN3: P9.38 (AIN3)
AM-VIN: SHIELD101.V_IN
AREF: SHIELD101.AREF
AXIS_ENAn: P9.14 (EHRPWM1A)
D2-FET6: SHIELD101.2 (D2)
D8: SHIELD101.8 (D8)
D9: SHIELD101.9 (D9)
D10: SHIELD101.10 (D10)
D11-FET4: SHIELD101.11 (D11)
D12-FET5: SHIELD101.12 (D12)
D13: SHIELD101.13 (D13)
D23: SHIELD101.23 (D23)
D25: SHIELD101.25 (D25)
D27: SHIELD101.27 (D27)
D29: SHIELD101.29 (D29)
D31: SHIELD101.31 (D31)
D32: P9.24 (UART1_TXD), SHIELD101.32 (D32)
D33: SHIELD101.33 (D33)
D35: SHIELD101.35 (D35)
D37: SHIELD101.37 (D37)
D39: SHIELD101.39 (D39)
D41: P9.18 (I2C1_SDA), SHIELD101.41 (D41)
D43: P9.17 (I2C1_SCL), SHIELD101.43 (D43)
D45: SHIELD101.45 (D45)
D47: P9.26 (UART1_RXD), SHIELD101.47 (D47)
D49: SHIELD101.49 (D49)
D50-MISO: SHIELD101.50 (D50-MISO)
D51-MOSI: SHIELD101.51 (D51-MOSI)
D52-SCK: SHIELD101.52 (D52-SCK)
DGND: BB101.M1, BB101.M2, BB101.M3, BB101.M4, LD102.K, P8.1 (DGND), P8.2 (DGND), P9.1 (DGND), P9.2 (DGND), P9.43 (DGND), P9.44 (DGND), P9.45 (DGND), P9.46 (DGND), P101.1, P102.2, P103.2, P106.6, Q101.S, SHIELD101.GND, SW101.2, SW102.2
DUE_5V: SHIELD101.5V
E0_DIR: P9.12 (GPIO1_28), SHIELD101.28 (D28)
E0_EN: SHIELD101.42 (D42)
E0_STEP: P9.16 (EHRPWM1B), SHIELD101.36 (D36)
ESTOP: P8.17 (GPIO0_27), SHIELD101.40 (D40)
ESTOP_SW: P8.26 (GPIO1_29)
FET1: P8.11 (GPIO1_13)
FET2: P9.15 (GPIO1_16)
FET3: P9.27 (GPIO3_19)
FET4: P9.21 (UART2_TXD)
FET5: P9.41 (CLKOUT2)
FET6: P9.22 (UART2_RXD)
GNDA: SHIELD101.GND4 (GND), SHIELD101.GND5 (GND)
IOREF: SHIELD101.IORF (IOREF)
LED: P9.25 (GPIO3_21), Q101.G
MACHINE_PWR: P9.23 (GPIO1_17)
MISO: P9.29 (SPI1_D0), P106.1
MOSI: P9.30 (SPI1_D1), P106.4
unnamed: LD101.A, R101.2
unnamed: LD101.K, Q101.D
unnamed: LD102.A, R102.2
PS-ON: SHIELD101.53 (D53-SS)
PWR_BUT: P9.9 (PWR_BUT), P102.1, SW101.1
RESET: SHIELD101.RST
RESETn: P9.10 (SYS_RESETn), P103.1, SW102.1
SCK: P9.31 (SPI1_SCLK), P106.3
SCL: P9.19 (I2C2_SCL), SHIELD101.21 (D21-SCL)
SCL1: SHIELD101.SCL1
SDA: P9.20 (I2C2_SDA), SHIELD101.20 (D20-SDA)
SDA1: SHIELD101.SDA1
SERVO1: SHIELD101.7 (D7)
SERVO2: SHIELD101.6 (D6)
SERVO3: SHIELD101.5 (D5)
SERVO4: SHIELD101.3 (D3)
SPI_CS0: P9.28 (SPI1_CS0)
SPI_CS1: P9.42 (GPIO0_7), SHIELD101.4 (D4)
SPI_SPARE: P8.16 (GPIO1_14)
THERM0: P9.33 (AIN4), SHIELD101.AD0
THERM1: P9.36 (AIN5), SHIELD101.AD1
THERM2: P9.35 (AIN6), SHIELD101.AD2
THERM3: SHIELD101.AD3
UART0_RX_LV: SHIELD101.0 (D0-RX0)
UART0_TX_LV: SHIELD101.1 (D1-TX0)
UART1_RX_LV: SHIELD101.19 (D19-RX1)
UART1_TX_LV: SHIELD101.18 (D18-TX1)
UART2_RX_LV: SHIELD101.17 (D17-RX2)
UART2_TX_LV: SHIELD101.16 (D16-TX2)
UART3_RX_LV: SHIELD101.15 (D15-RX3)
UART3_TX_LV: SHIELD101.14 (D14-TX3)
VDD_5V: P9.5 (VDD_5V), P9.6 (VDD_5V)
X-MAX: P8.7 (TIMER4), SHIELD101.30 (D30)
X-MIN: P8.8 (TIMER7), SHIELD101.22 (D22)
X_DIR: P8.12 (GPIO1_12), SHIELD101.AD8
X_EN: SHIELD101.48 (D48)
X_STEP: P8.13 (EHRPWM2B), SHIELD101.AD9
Y-MAX: P8.9 (TIMER5), SHIELD101.38 (D38)
Y-MIN: P8.10 (TIMER6), SHIELD101.24 (D24)
Y_DIR: P8.14 (GPIO0_26), SHIELD101.AD10
Y_EN: SHIELD101.46 (D46)
Y_STEP: P8.15 (GPIO1_15), SHIELD101.AD11
Z-MAX: P9.11 (UART4_RXD), SHIELD101.34 (D34)
Z-MIN: P9.13 (UART4_TXD), SHIELD101.26 (D26)
Z_DIR: P8.18 (GPIO2_1), SHIELD101.AD12 (DAC0-AD12)
Z_EN: SHIELD101.44 (D44)
Z_STEP: P8.19 (EHRPWM2A), SHIELD101.AD13 (DAC1-AD13)

Notes on the sheet:
STATUS LED
HDMI
eMMC
Audio
BeagleBone serial console pass-through header
SCL1 UART1_TX
SDA1 UART1_RX
To save money on all the pin headers when buying parts for a few boards, you can get large breakaway headers instead of the individual parts. You will need a total of: 18 pins of single-row header 82 pins of dual-row header Which you can get using (1) Harwin M20-9993645 36-pin single-row header (2)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
BB ON LED
BeagleBone Logic supply is always 3.3V
SYS_5V: Low-current supply provided by BeagleBone PMIC Active when BeagleBone is running
D3.3V: Low-current supply from 500 mA LDO on BeagleBone
Serial Console
Uses Arduino 6-pin stacking connector for low-cost
Power
Reset
STEP_U
STEP_V
STEP_W
DIR_U
DIR_V
DIR_W
Also used by Programming USB port
X/Y/Z pins are on single port for both Mega and Due
ARDUINO
