scottjgibson/bobc_hardware/RosettaBone_Redux/con_inputs.sch

## KiCad design RosettaBone_Redux/con_inputs.sch (2015-01-14, an earlier design)

Schematic: con_inputs.sch

Parts:
C501, C502, C503, C504, C505: 100n; CAPC1608x55N; PartNo GRM188R71C104KA01D
C506, C507, C508, C509: 10u; CAPC1608x55N; PartNo JMK107ABJ106MAHT
JP501: HEADER_2; pin_strip_2; PartNo M20-9990245
P501: HEADER_6; pin_strip_6; PartNo M20-9990645
P502: HEADER_6X2; pin_strip_6x2; PartNo M20-9980645
P503, P504: HEADER_4X2; pin_strip_4x2; PartNo M20-9980445
R501, R502, R503, R504, R505, R506, R507, R508, R509, R510: 10k; RESC1608x55N; PartNo RMCF0603FT10K0
R511, R512, R513, R514: 2K0 1%; RESC1608x55N; PartNo RMCF0603FT2K00
R515, R516, R517, R518: 4k7; RESC1608x55N; PartNo RMCF0603FT4K70
S501: SHUNT; Shunt; PartNo 382811-8
U501: 74CBTD3861; SOIC127P1030X265-24N

Notes on the sheet:
Endstop inputs are 5V tolerant and may also be used as 3.3V output signals if desired
Endstops
From Thermistors
Thermistor Inputs
Shunt populated by default Remove to support 4-wire touch-screen using AIN 0-3
To ADC Inputs
P503 may be used for: * Additional digital I/O * CRAMP3 add-on board * SPI expansion
STEP_V
STEP_W
DIR_V
DIR_W
