scottjgibson/bobc_hardware/RosettaBone_Redux/con_outputs.sch

## KiCad design RosettaBone_Redux/con_outputs.sch (2015-01-14, an earlier design)

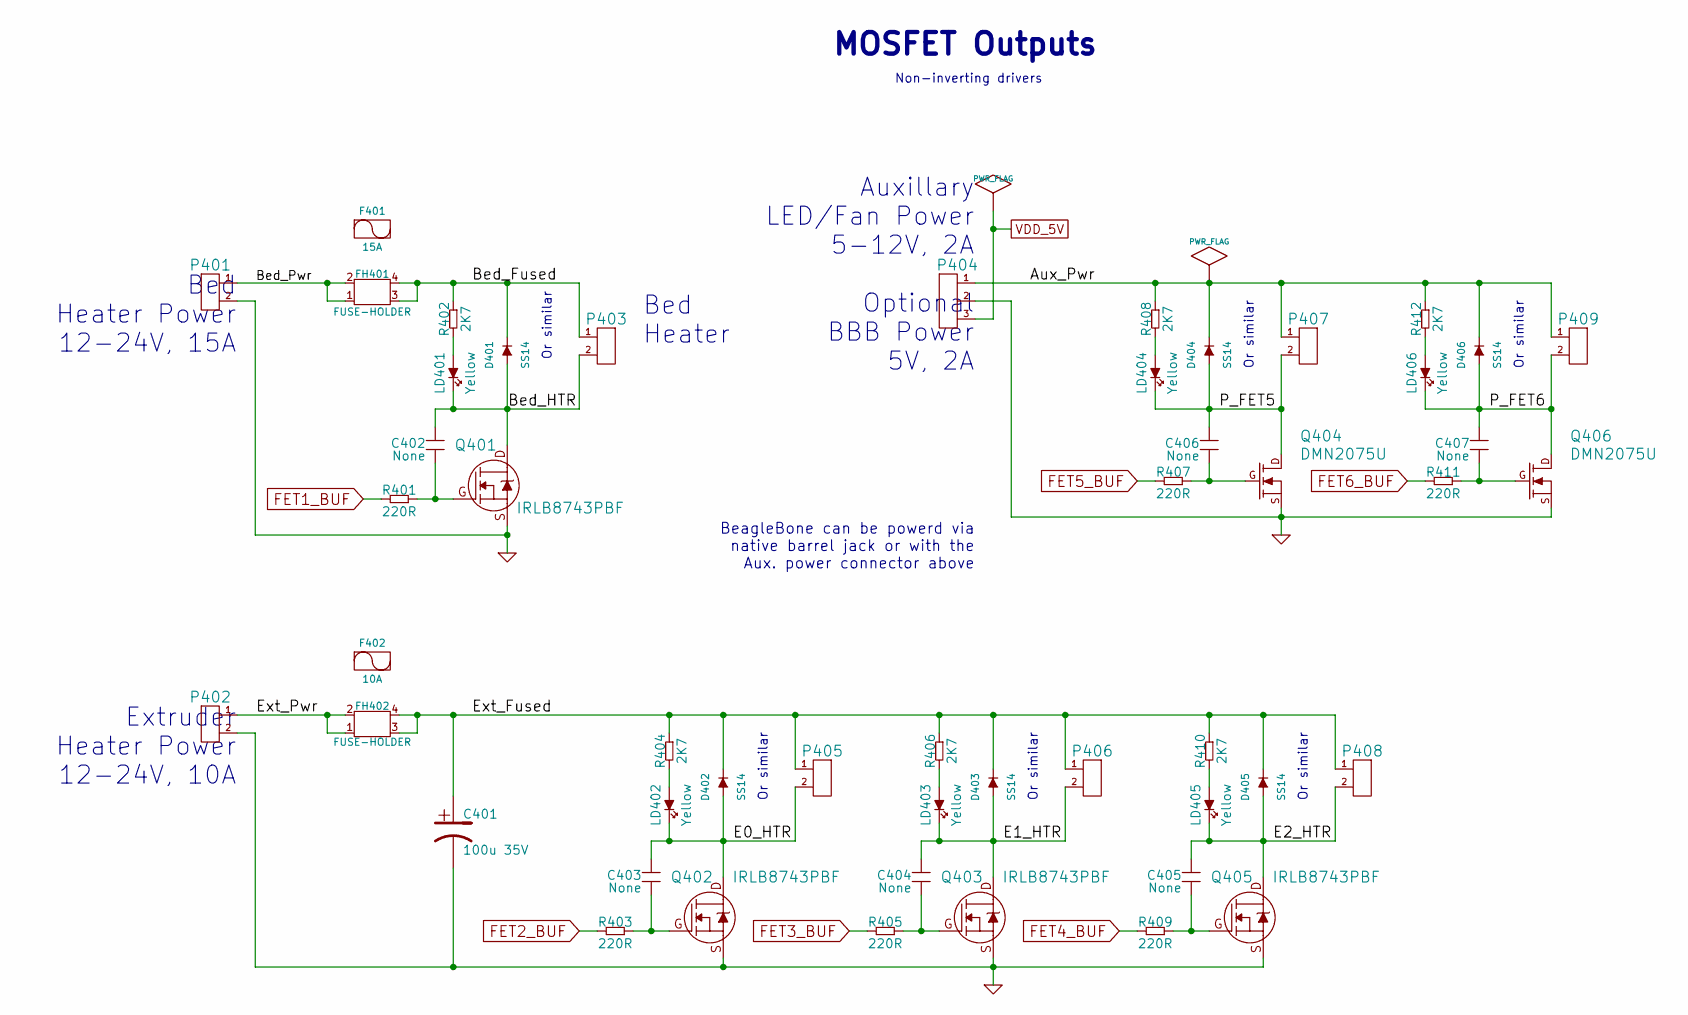
[picture p10: schematic con_outputs.sch]

Parts:
C401: 100u 35V; c_elec_6.3x7.7; PartNo UCD1V101MCL6GS
C402, C403, C404, C405, C406, C407: None; CAPC1608x55N; PartNo Do Not Populate
D401, D402, D403, D404, D405, D406: SS14; DIOM5127X229N; PartNo SS14-E3/61T
F401: 15A; Fuse-Loose; PartNo 0297015.WXNV
F402: 10A; Fuse-Loose; PartNo 0297010.WXNV
FH401, FH402: FUSE-HOLDER; Keystone-3568; PartNo 3568
LD401, LD402, LD403, LD404, LD405, LD406: Yellow; OSRAM-LED-0603; PartNo LY Q976-P1S2-36
P401, P402, P403: PT_2,5-2-5,0-H; PartNo 1935776
P404: PT_1,5-3-3,5-H; PartNo 1984620
P405, P406, P408: PT_1,5-2-3,5-H; PartNo 1984617
P407, P409: KK-2.54-2W; CONN_KK_2.54_2W; PartNo 22-23-2021
Q401, Q402, Q403, Q405: IRLB8743PBF; TO-220AB_IRF2804_RMC; PartNo IRLB8743PBF
Q404, Q406: DMN2075U; SOT23GDS; PartNo DMN2075U-7
R401, R403, R405, R407, R409, R411: 220R; RESC1608x55N; PartNo RMCF0603FT220R
R402, R404, R406, R408, R410, R412: 2K7; RESC1608x55N; PartNo RMCF0603FT2K70

Connections:
Aux_Pwr: D404.K, D406.K, P404.1, P407.1, P409.1, R408.1, R412.1
Bed_Fused: D401.K, FH401.3, FH401.4, P403.1, R402.1
Bed_HTR: C402.1, D401.A, LD401.K, P403.2, Q401.D
Bed_Pwr: FH401.1, FH401.2, P401.1
E0_HTR: C403.1, D402.A, LD402.K, P405.2, Q402.D
E1_HTR: C404.1, D403.A, LD403.K, P406.2, Q403.D
E2_HTR: C405.1, D405.A, LD405.K, P408.2, Q405.D
Ext_Fused: C401.1, D402.K, D403.K, D405.K, FH402.3, FH402.4, P405.1, P406.1, P408.1, R404.1, R406.1, R410.1
Ext_Pwr: FH402.1, FH402.2, P402.1
FET1_BUF: R401.2
FET2_BUF: R403.2
FET3_BUF: R405.2
FET4_BUF: R409.2
FET5_BUF: R407.2
FET6_BUF: R411.2
GND: C401.2, P401.2, P402.2, P404.2, Q401.S, Q402.S, Q403.S, Q404.S, Q405.S, Q406.S
unnamed: C402.2, Q401.G, R401.1
unnamed: C403.2, Q402.G, R403.1
unnamed: C404.2, Q403.G, R405.1
unnamed: C405.2, Q405.G, R409.1
unnamed: C406.2, Q404.G, R407.1
unnamed: C407.2, Q406.G, R411.1
unnamed: LD401.A, R402.2
unnamed: LD402.A, R404.2
unnamed: LD403.A, R406.2
unnamed: LD404.A, R408.2
unnamed: LD405.A, R410.2
unnamed: LD406.A, R412.2
P_FET5: C406.1, D404.A, LD404.K, P407.2, Q404.D
P_FET6: C407.1, D406.A, LD406.K, P409.2, Q406.D
VDD_5V: P404.3

Notes on the sheet:
Non-inverting drivers
MOSFET Outputs
Or similar
Bed Heater Power 12-24V, 15A
Bed Heater
Extruder Heater Power 12-24V, 10A
Auxillary LED/Fan Power 5-12V, 2A Optional BBB Power 5V, 2A
BeagleBone can be powerd via native barrel jack or with the Aux. power connector above
