scottjgibson/bobc_hardware/RosettaBone_Redux/e-stop.sch

## KiCad design RosettaBone_Redux/e-stop.sch (2015-01-14, an earlier design)

Schematic: e-stop.sch

Parts:
C301, C302: 100n; CAPC1608x55N; PartNo GRM188R71C104KA01D
JP301: HEADER_2X2; pin_strip_2x2; PartNo M20-9980245
LD301: Green; OSRAM-LED-0603; PartNo LG Q971-KN-1
LD302: Red; OSRAM-LED-0603; PartNo LS Q976-NR-1
P301: HEADER_2; pin_strip_2; PartNo M20-9990245
P302: KK-2.54-2W; CONN_KK_2.54_2W; PartNo 22-23-2021
P303: HEADER_4X2; pin_strip_4x2; PartNo M20-9980445
P304: HEADER_3X2; pin_strip_3x2; PartNo M20-9980345
P305: HEADER_6; pin_strip_6; PartNo M20-9990645
Q301, Q302, Q303, Q304, Q305: 2N7002K; SOT23GDS; PartNo 2N7002K-7
R301, R308, R309, R310, R311, R312, R313, R315, R316: 10k; RESC1608x55N; PartNo RMCF0603FT10K0
R302: 2K7; RESC1608x55N; PartNo RMCF0603FT2K70
R303: 330R; RESC1608x55N; PartNo RMCF0603FT330R
R304, R306, R307, R314: 4k7; RESC1608x55N; PartNo RMCF0603FT4K70
R305: 220R; RESC1608x55N; PartNo RMCF0603FT220R
S301: SHUNT; Shunt; PartNo 382811-8
U301: 24C256; SOIC127P600X175-8AN; PartNo CAT24C256WI-GT3
U302: 74ACT244; SOIC127P1032X265-20N; PartNo 74ACT244SCX

Notes on the sheet:
Emergency Stop switch (Normally Closed type) use shunt if not present
Active low
Active high
Must use ACT type buffer with 24 mA output drive Inputs are compatible with 3.3V or 5V logic
Each Pololu has a 100K pull-down on the enable line. Make sure the pull up will reach a valid logic level (2.2V or more) with multiple enables paralleled.
ESTOP Active (high) unless: * ESTOP chain is unbroken * Software is driving ESTOP_SW low
Machine Power Status LED
EEPROM
Address and WP pins have internal pull-down Default configuration is no shunts populated: Addr = 0xA8 WP = Disabled (writes allowed)
I2C and misc signals
Analog
Resistive Touch Screen
ATX Power On
Two FETs used to keep ESTOP polarity consistent with V1.0
ESTOP
Place a shunt on ESTOP header by default, for folks who do not have an off-board ESTOP switch
Motor Power
CRAMP3 Expansion
Series resistor on ESTOPn provides some protection from ESTOP chain FETs protect against high voltage from PS_ON or MACHINE_PWRn feeding back to the 3.3V 'Bone
ACTIVE
Status LED
STEP_U
DIR_U
