scottjgibson/bobc_hardware/RosettaBone_Redux/steppers.sch

## KiCad design RosettaBone_Redux/steppers.sch (2015-01-09)

Schematic: steppers.sch

Parts:
C201, C202, C203, C204, C205, C206: 100u 35V; c_elec_6.3x7.7; PartNo UCD1V101MCL6GS
F201: 10A; Fuse-Loose; PartNo 0297010.WXNV
FH201: FUSE-HOLDER; Keystone-3568; PartNo 3568
JP201, JP202, JP203, JP204, JP205, JP206: HEADER_3X2; pin_strip_3x2; PartNo M20-9980345
P201: PT_2,5-2-5,0-H; PartNo 1935776
P202, P203, P204, P205, P206, P207: KK-2.54-4W; CONN_KK_2.54_4W; PartNo 22-23-2041
P208, P209, P210, P211: POLOLU_SOCKET; Pololu_Socket; PartNo PPTC241LFBN-RC
R201, R202, R203, R204, R205, R206: 100k; RESC1608x55N; PartNo RMCF0603FT100K
S201, S202, S203, S204, S205, S206, S207, S208, S209, S210, S211, S212, S213, S214, S215, S216, S217, S218: SHUNT; Shunt; PartNo 382811-8
U201, U202, U203, U204, U205, U206: Pololu; POLOLU; PartNo DRV8825

Notes on the sheet:
Motor Power 12-24V, 10A
24-pin Single-Row sockets for Pololus
Shunts to set micro-stepping
