scottjgibson/bobc_hardware/(commit log)

2014-02-16 Redeuce size of PCB to 3.9" x 3.9" by just chopping off 0.050" from the top and bottom to test low-cost prototypes from iteadstudio.com (10x10 cm size limit)
    [CRAMPS.routed-B_Mask.gbs, CRAMPS.routed-B_SilkS.gbo, CRAMPS.routed-Back.gbl, CRAMPS.routed-Edge_Cuts.gbr, CRAMPS.routed-F_Mask.gts, CRAMPS.routed-F_Paste.gtp, CRAMPS.routed-F_SilkS.gto, CRAMPS.routed-Front.gtl]
2015-01-09 Initial Commit of RosettaBone Redux design
    [RBR-BOM-v1.1.xlsx, RBR.BOM.DK.V1.0.xls, RBR.csv, RBR.kicad_pcb, RBR.sch, con_inputs.sch, con_outputs.sch, e-stop.sch]
