scottjgibson/bobc_hardware/(notices)

Notices in the files:
RosettaBone_Redux/RBR.kicad_pcb:
© 2014
GPL v3
